georgeuy2/QuadcopterBT/DroneBT_app_block_code.jpg

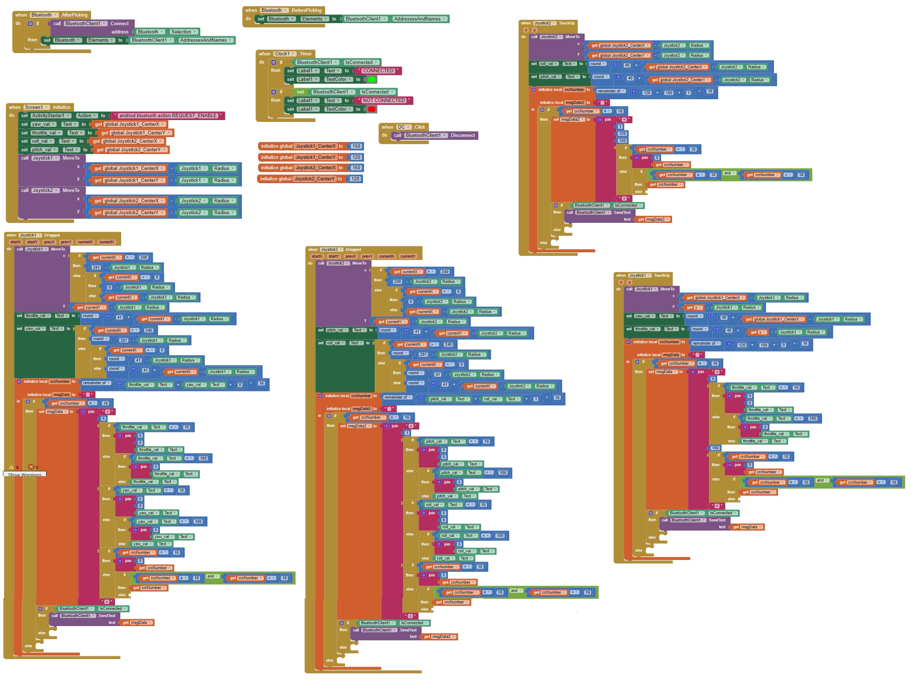
DroneBT_app_block_code.jpg
