georgeuy2/QuadcopterBT/README.md

# QuadcopterBT
Goal:
My goal was to build a quadcopter that could fly and be controlled with an app.

Parts: 
Quadcopter frame
Lipo Battery 3C 2200mAh
4 x 1100KV brushless motors
4 x ESC 30A
Bluetooth receiver HC-05
MPU-6050 gyroscope and accelerometer
Arduino Uno
Header pins
Jumper wires
Android phone
