georgeuy2/QuadcopterBT/droneBT_schematic.pdf

HC-05

# Motor

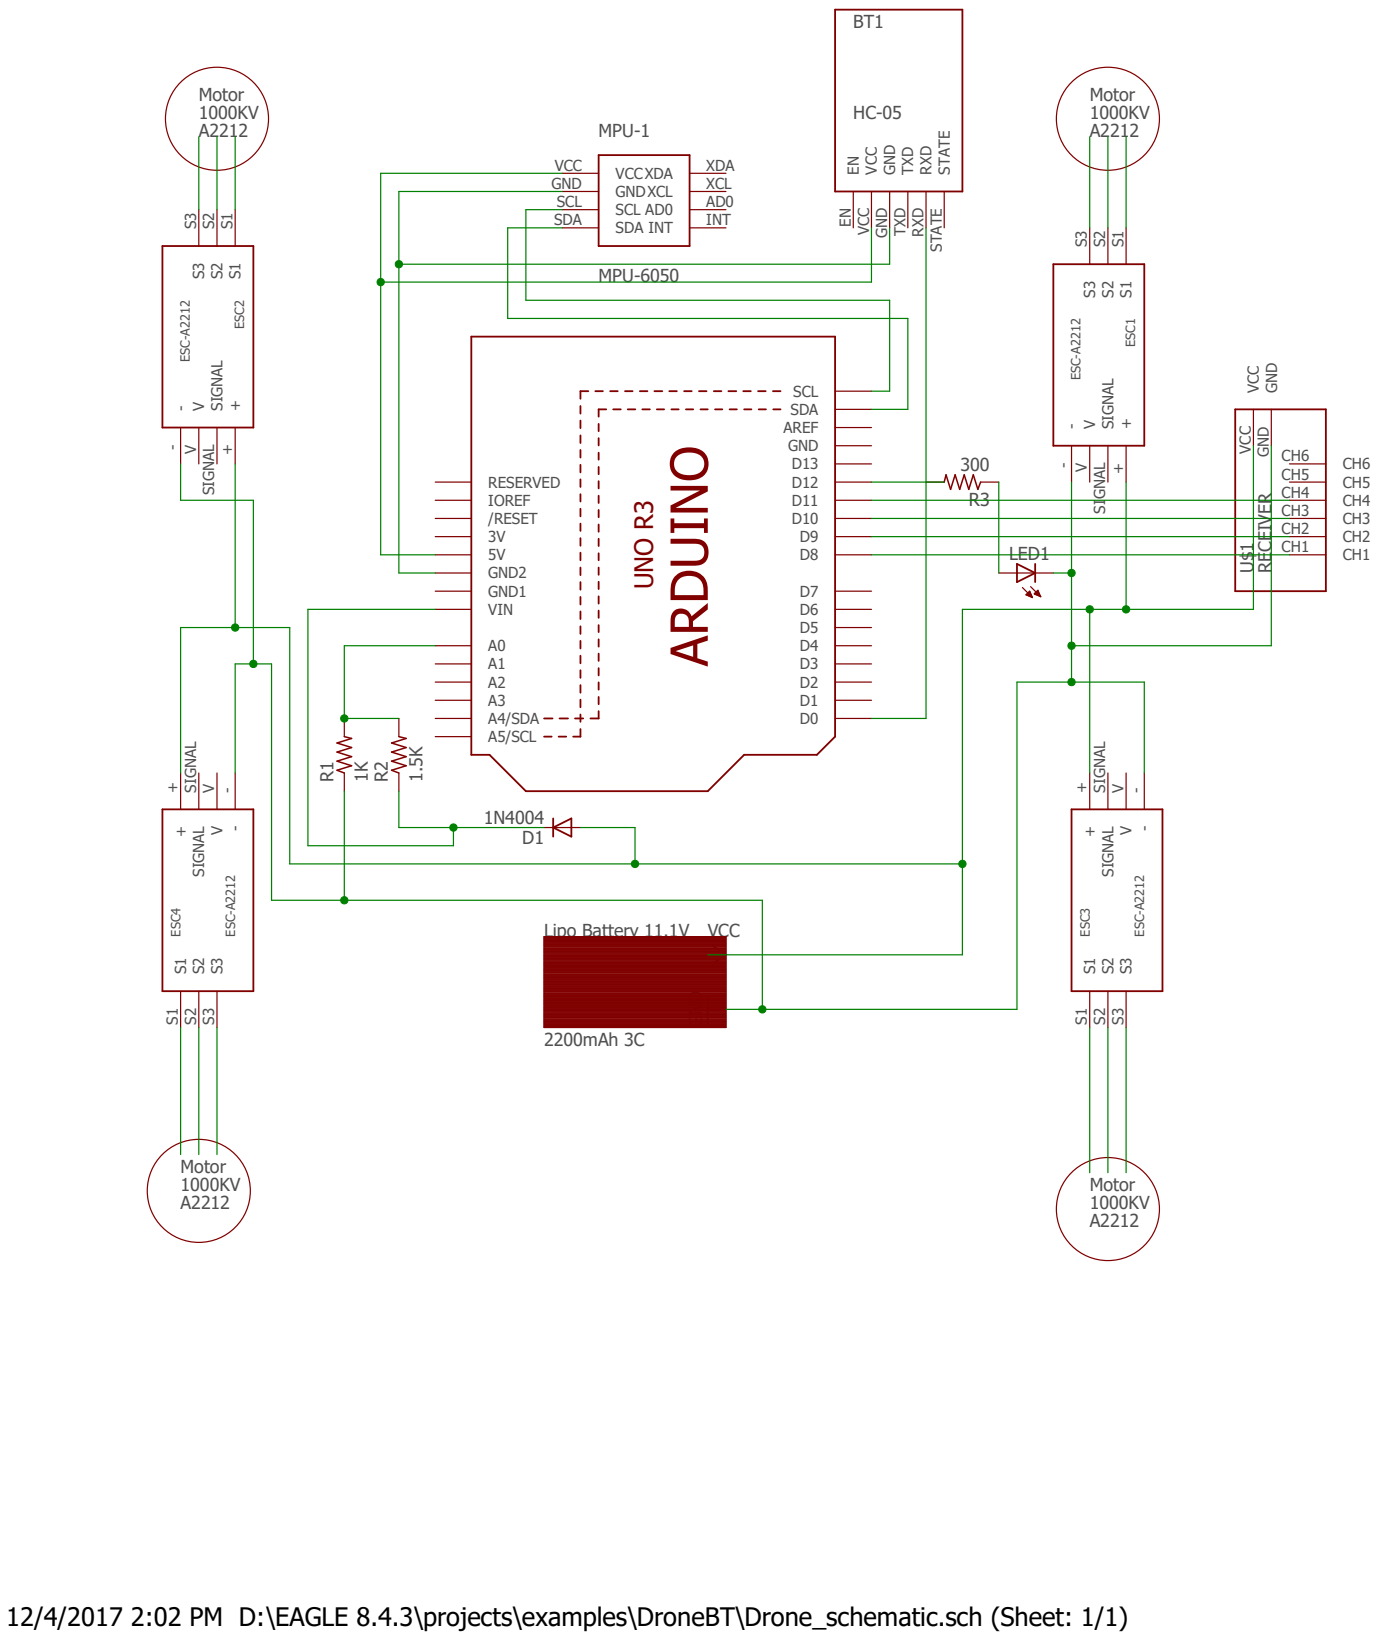
[picture p21: page 1]

- ESC4 STATE STATE RXD RXD TXD TXD GND GND VCC VCC EN EN

CH1 CH1 VCC VCC GND GND U$1 ARDUINO UNO R³

LED1

12/4/2017 2:02 PM D:\EAGLE 8.4.3\projects\examples\DroneBT\Drone_schematic.sch (Sheet: 1/1)
